Samdood/LoopPedal/docs/images/breadboard-prototype.png

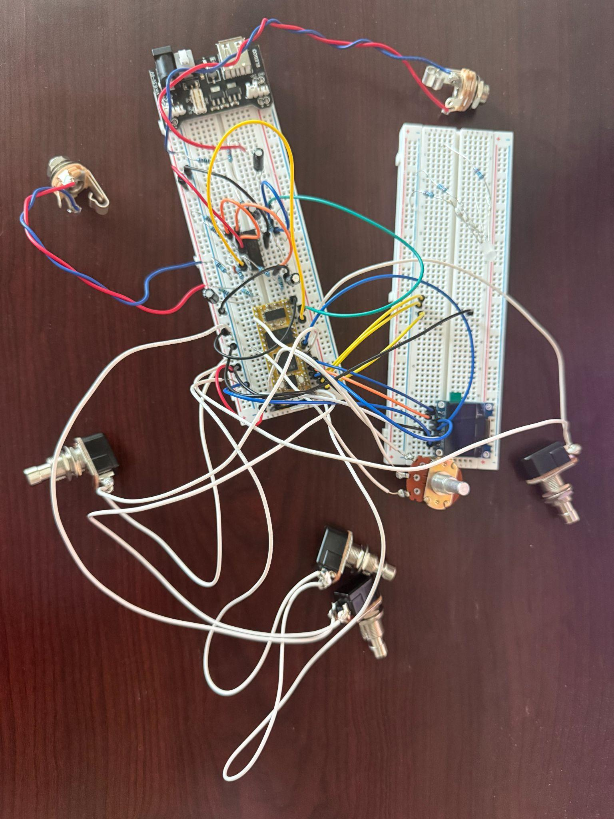
docs/images/breadboard-prototype.png
