Samdood/LoopPedal/docs/images/pedal-prototype.png

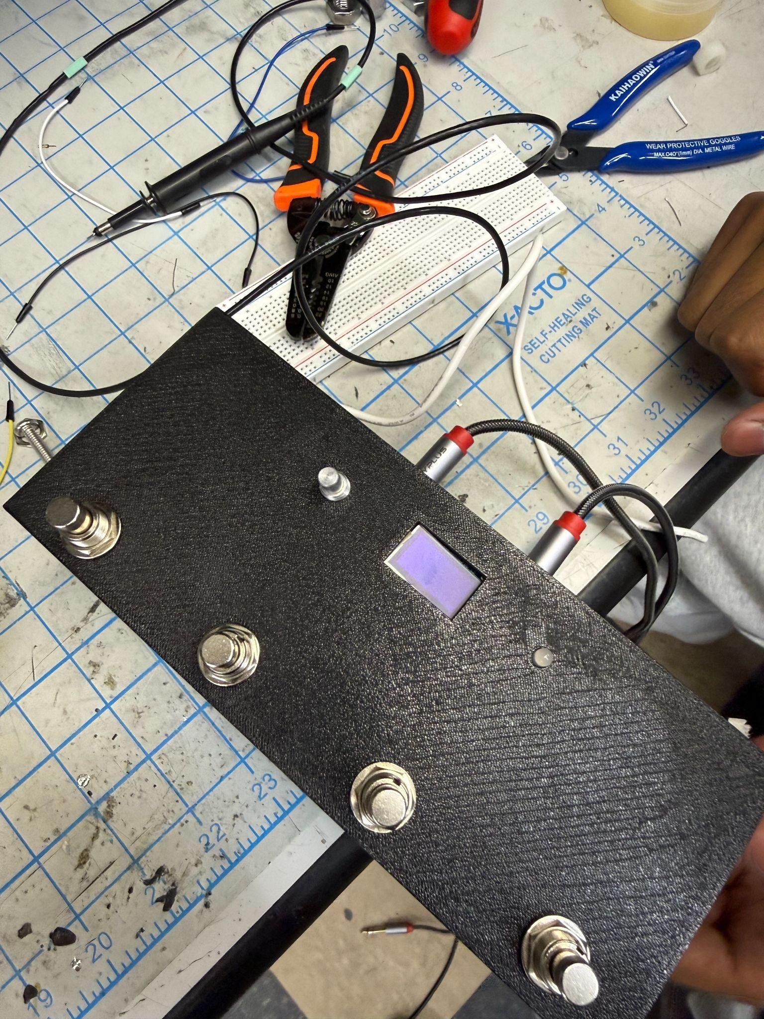
docs/images/pedal-prototype.png
