Samdood/LoopPedal/IMG_1865.jpeg

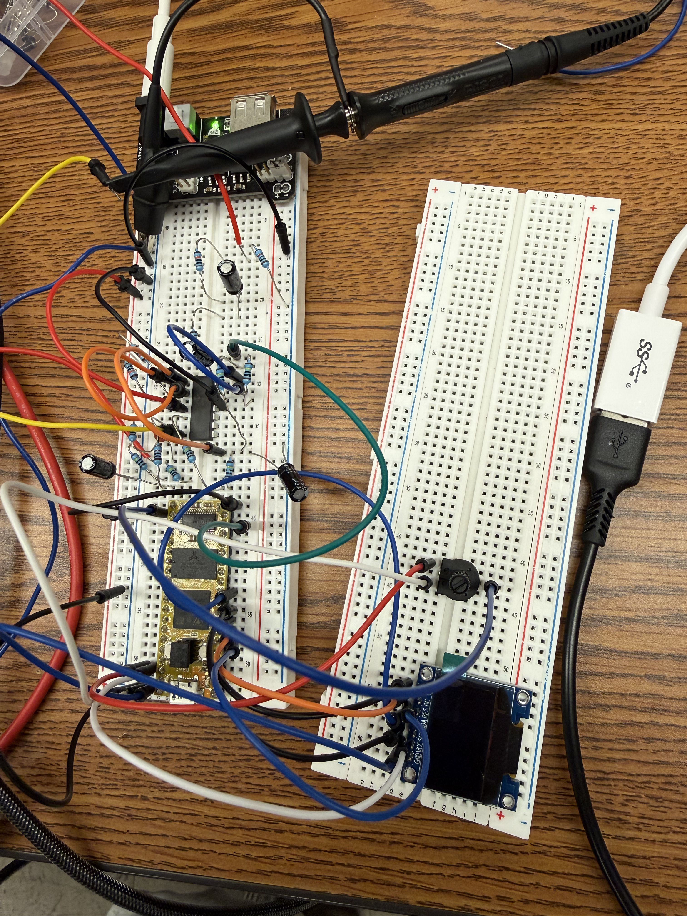
IMG_1865.jpeg
